protoni/stm32-template/README.md

# stm32-template
Basic starter for STM32F1* MCUs
