protoni/stm32-template/MCU/application/Core/Src/main.c

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
/* Includes ------------------------------------------------------------------*/
#include "main.h"

/* USER CODE BEGIN PTD */
#include <stdio.h>
#include <string.h>

/* USER CODE END PTD */

/* USER CODE BEGIN PM */

// Application version information
#define MAJOR_VERSION 0
#define MINOR_VERSION 1

// LED macros
#define Toggle_Status_LED() HAL_GPIO_TogglePin(GPIOC, GPIO_PIN_3)
#define Toggle_USER_LED1() HAL_GPIO_TogglePin(GPIOC, GPIO_PIN_4)
#define Toggle_USER_LED2() HAL_GPIO_TogglePin(GPIOC, GPIO_PIN_5)

// Sleep macros
#define Sleep(x) HAL_Delay(x * 1000);
#define Sleep_MS(x) HAL_Delay(x);

/* USER CODE END PM */

UART_HandleTypeDef huart1;

PCD_HandleTypeDef hpcd_USB_FS;

// Bootloader version information
uint8_t App_Version[2] = { MAJOR_VERSION, MINOR_VERSION};

// LED cycle for bootloader starting
uint8_t App_Start_LED_Cycle_Times = 5;
uint16_t App_Start_LED_Cycle_Delay = 1;

void SystemClock_Config(void);
static void MX_GPIO_Init(void);
static void MX_USB_PCD_Init(void);
static void MX_USART1_UART_Init(void);
/**
  * @brief  The application entry point.
  * @retval int
  */
int main(void)
{
  /* USER CODE BEGIN 1 */
	// Re-enable interrupts
  __enable_irq();
  /* USER CODE END 1 */

  /* MCU Configuration--------------------------------------------------------*/

  /* Reset of all peripherals, Initializes the Flash interface and the Systick. */
  HAL_Init();

  /* Configure the system clock */
  SystemClock_Config();

  /* Initialize all configured peripherals */
  MX_GPIO_Init();
  MX_USB_PCD_Init();
  MX_USART1_UART_Init();
  /* USER CODE BEGIN 2 */

  printf("Application version %d.%d started!\r\n",
		  App_Version[0], App_Version[1]);

  /* USER CODE END 2 */

  /* Infinite loop */
  /* USER CODE BEGIN WHILE */
  while (1)
  {
    /* USER CODE END WHILE */


    /* USER CODE BEGIN 3 */
	for(uint8_t i = 0; i < App_Start_LED_Cycle_Times; i++) {
		Toggle_Status_LED();

		Sleep(App_Start_LED_Cycle_Delay);
	}
  }
  /* USER CODE END 3 */
}

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
/* USER CODE BEGIN 4 */

#ifdef __GNUC__
  /* With GCC, small printf (option LD Linker->Libraries->Small printf
     set to 'Yes') calls __io_putchar() */
int __io_putchar(int ch)
#else
int fputc(int ch, FILE *f)
#endif /* __GNUC__ */
{
  /* Place your implementation of fputc here */
  /* e.g. write a character to the UART3 and Loop until the end of transmission */
  HAL_UART_Transmit(&huart1, (uint8_t *)&ch, 1, HAL_MAX_DELAY);

  return ch;
}

/* USER CODE END 4 */
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
