protoni/stm32-template/(commit log)

2023-10-25 Add STM32Cube project
    [stm32-template.kicad_pcb, stm32-template.kicad_sch]
2023-10-26 Add JTAG/SWD header
    [stm32-template.kicad_sch]
2023-10-26 Add LEDs, buttons, GPIO headers
    [stm32-template.kicad_sch]
2023-10-27 Add ESD protection and fuse
    [stm32-template.kicad_sch]
2023-10-28 Choose crystal and set capacitor footprints.
    [stm32-template.kicad_sch]
2023-10-28 Calculate LED resistors
    [stm32-template.kicad_sch]
2023-10-28 Assign rest of the footprints
    [stm32-template.kicad_sch]
2023-10-28 layout components
    [stm32-template.kicad_pcb]
2023-10-29 Finish routing
    [bom.csv, designators.csv, positions.csv, stm32-template.kicad_pcb, stm32-template.kicad_sch, stm32-template1.kicad_pcb]
2023-10-29 Add some labels
    [stm32-template.kicad_pcb]
2023-11-02 Change USB device select pull-up resistor to be software controllabe.
    [stm32-template.kicad_pcb, stm32-template.kicad_sch]
2023-11-02 Add reverse voltage diode to USB ESD protection chip VCC
    [stm32-template.kicad_pcb, stm32-template.kicad_sch]
2023-11-02 Match USB data lines impedance to 90 ohm.
    [stm32-template.kicad_pcb, stm32-template.kicad_sch]
2023-11-02 Add test pads and connect USB connector shield to GND.
    [bom.csv, designators.csv, positions.csv, stm32-template.kicad_pcb, stm32-template.kicad_sch]
2023-11-09 Add schematics
2024-04-22 Add custom bootloader
    [stm32-template Debug.cfg]
2024-04-22 Exclude stm32cube sources from LFS
2024-04-22 Remove STM32Cube sources from LFS and re-add to normal git.
2024-04-22 Fix issue where bootloader wouldn't load main application.
    [main.c]
2024-04-26 Add android app skeleton for interacting with the board
