protoni/stm32-template/(notices)

Notices in the files:
MCU/application/Core/Src/main.c:
Copyright (c) 2023 STMicroelectronics.
All rights reserved.
This software is licensed under terms that can be found in the LICENSE file
MCU/application/Core/Inc/main.h:
Copyright (c) 2024 STMicroelectronics.
